zeynepiremakbulut/esp32-autonomous-rover/docs/system architecture/tb6612 motor drivers.png

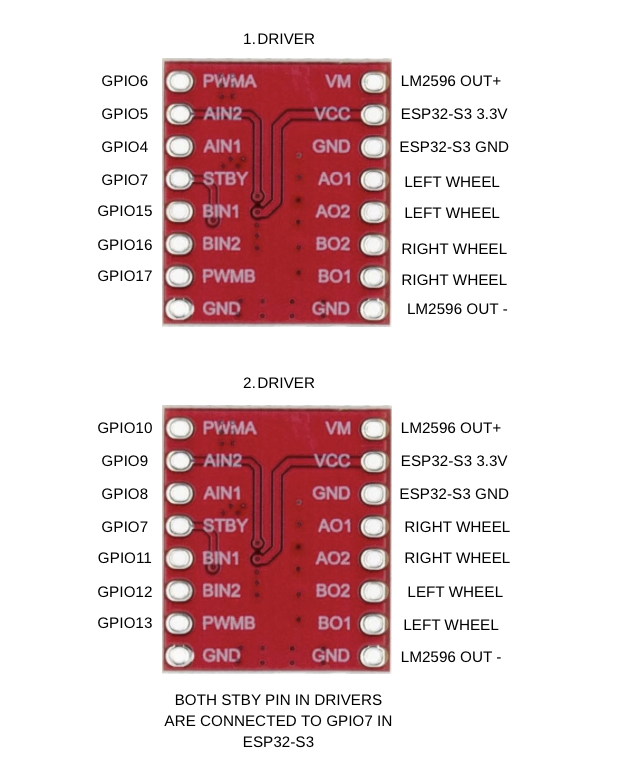
docs/system architecture/tb6612 motor drivers.png
