zeynepiremakbulut/esp32-autonomous-rover/docs/system architecture/lidar.png

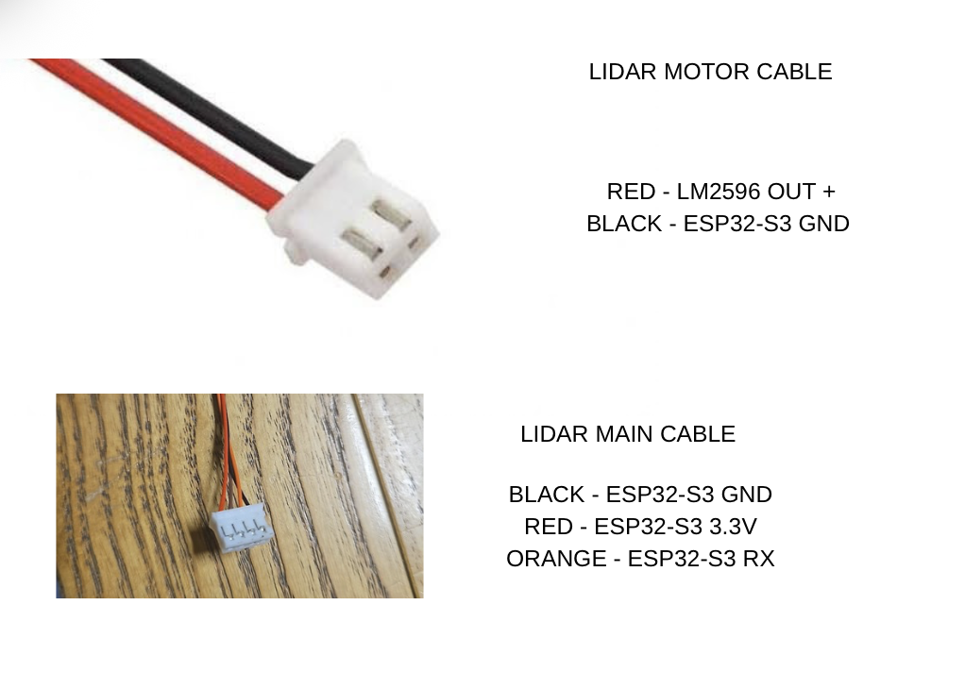
docs/system architecture/lidar.png
