zeynepiremakbulut/esp32-autonomous-rover/docs/system architecture/lm2596.png

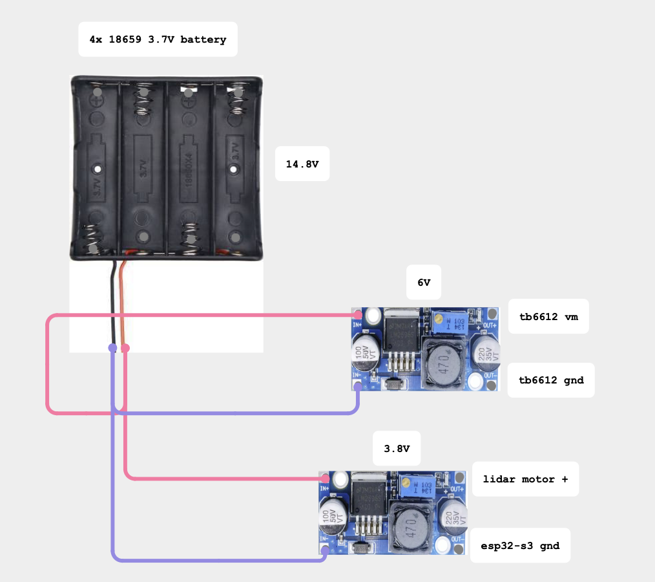
docs/system architecture/lm2596.png
