zeynepiremakbulut/esp32-autonomous-rover/media/front view.png

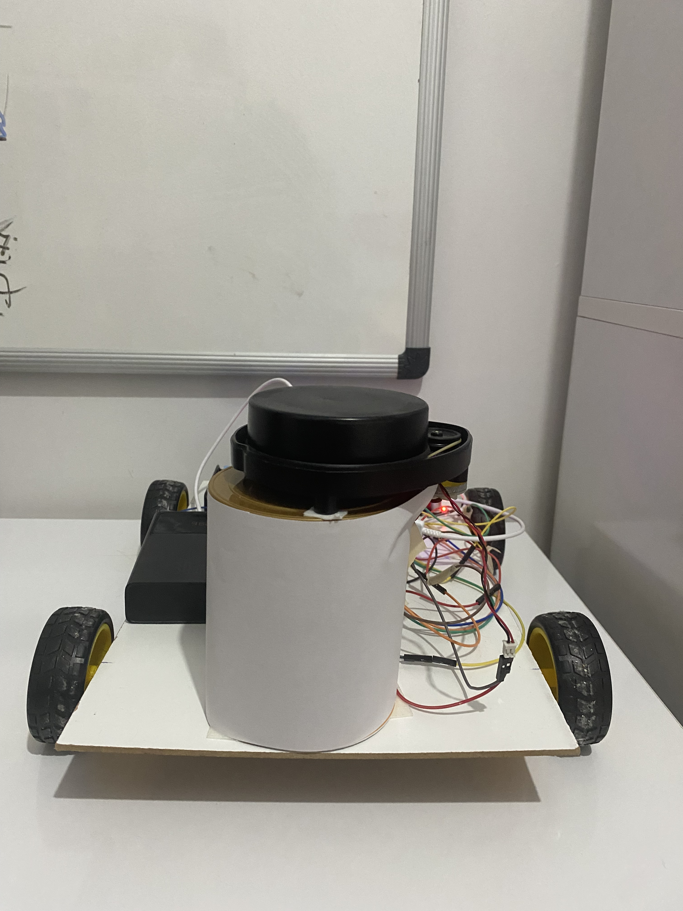
media/front view.png
