zeynepiremakbulut/esp32-autonomous-rover/media/main screen.png

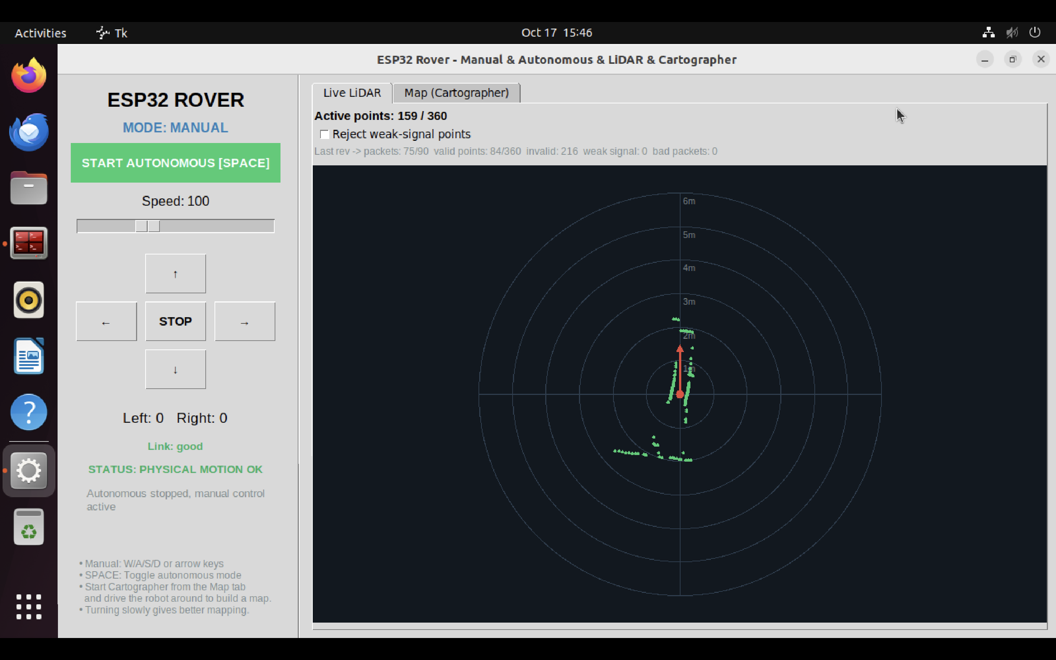
media/main screen.png
