zeynepiremakbulut/esp32-autonomous-rover/media/map screen.png

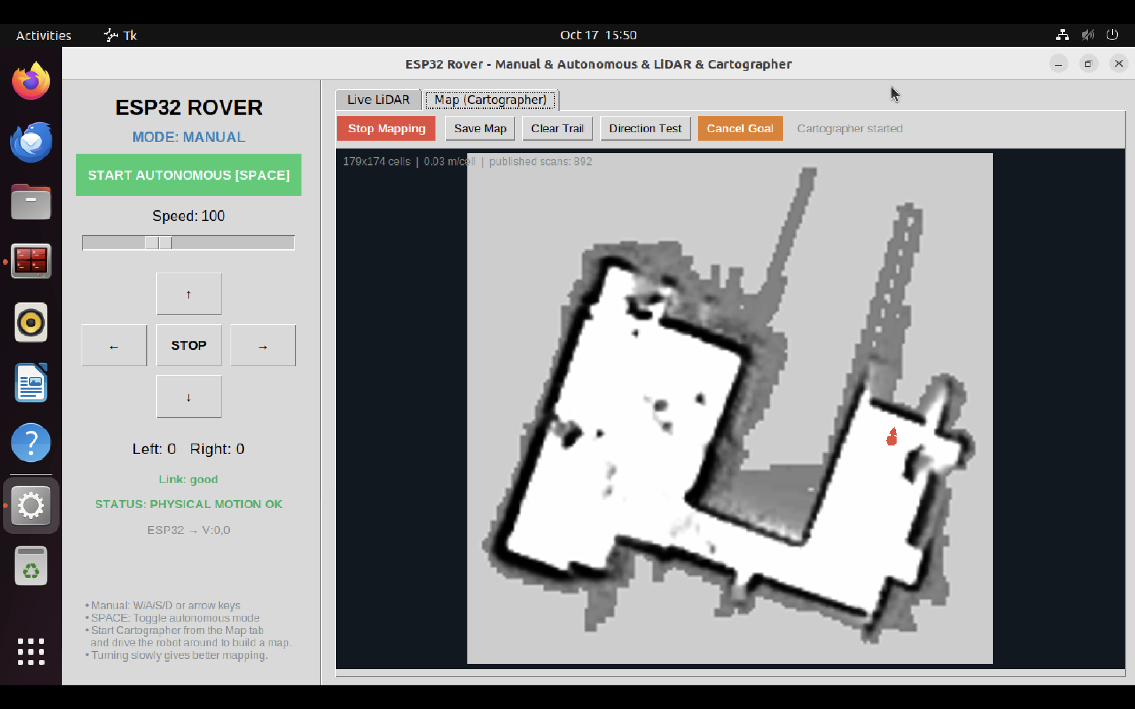
media/map screen.png
