zeynepiremakbulut/esp32-autonomous-rover/media/rover.png

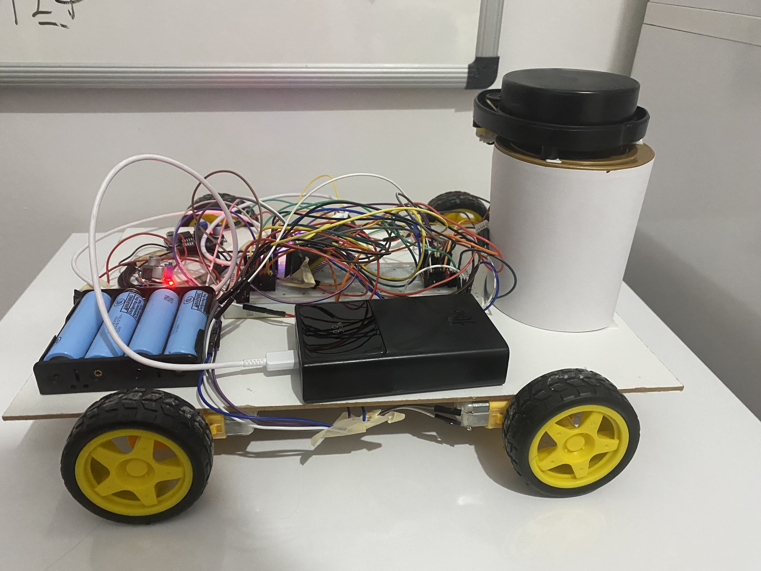
media/rover.png
