zeynepiremakbulut/esp32-autonomous-rover/media/top view.png

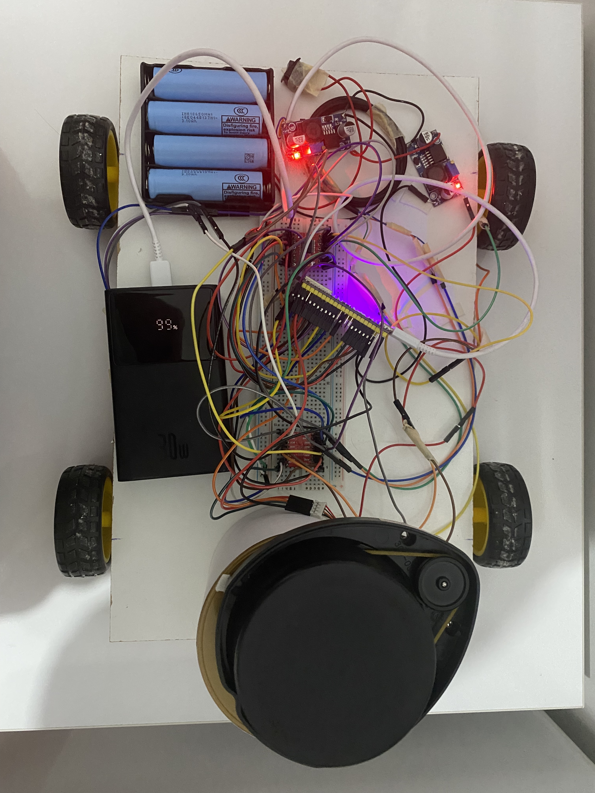
media/top view.png
